juandav65/Control_Levitador_Neumatico/piston (1).pdf

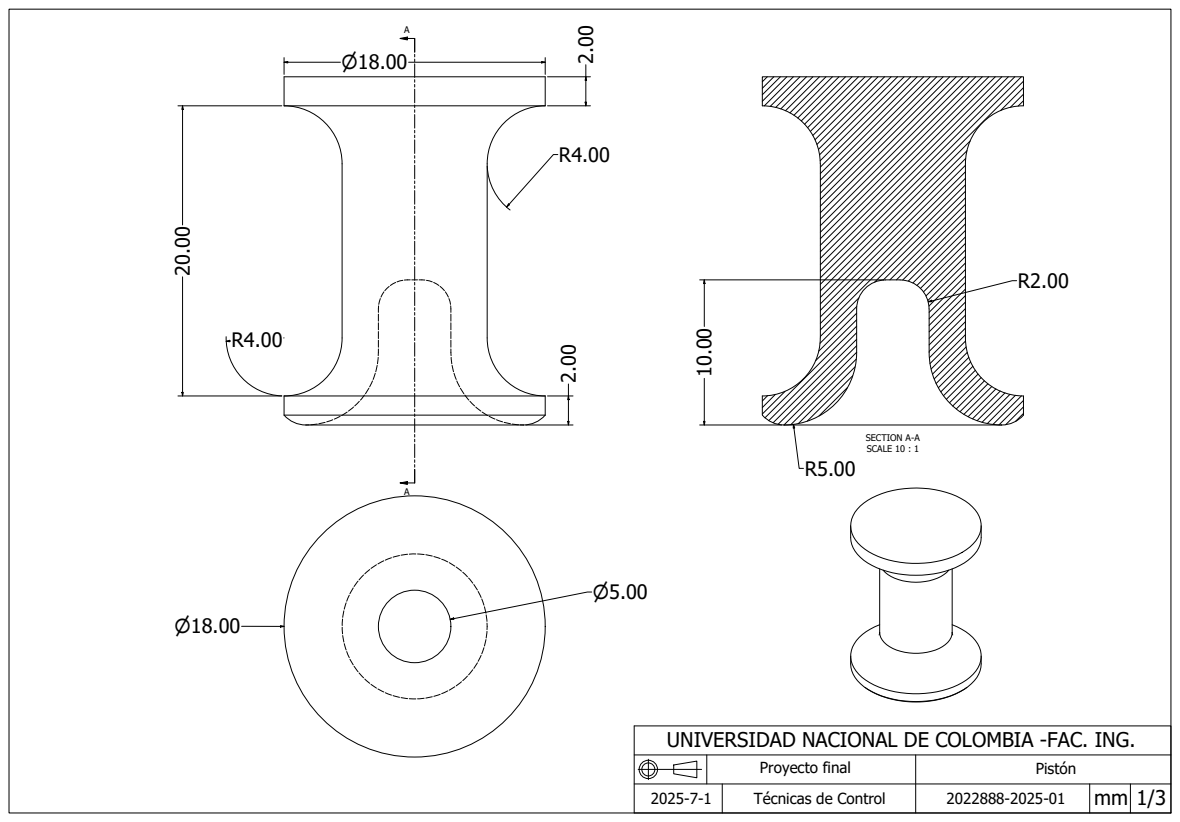
[picture p1: page 1]
SECTION A-A SCALE 10 : 1

UNIVERSIDAD NACIONAL DE COLOMBIA -FAC. ING.

Proyecto final | Pistón

2025-7-1 | Técnicas de Control | 2022888-2025-01 | mm | 1/3
