juandav65/Control_Levitador_Neumatico/BaseProyectoLevitador.pdf

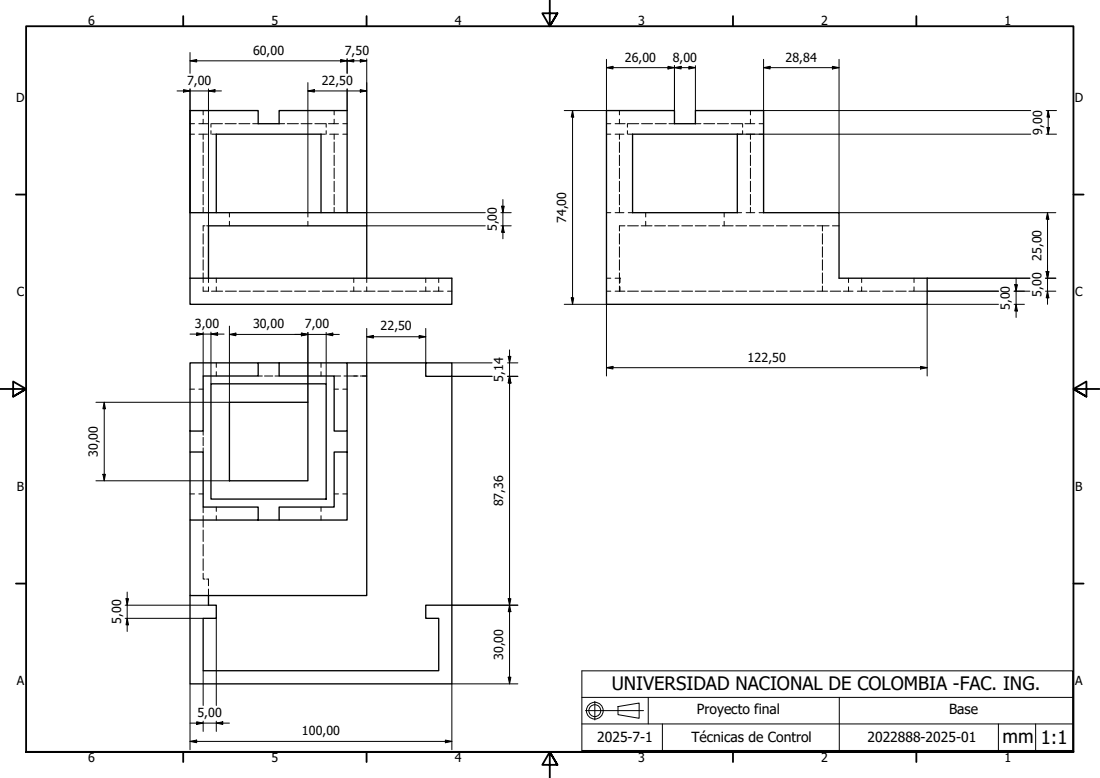
[picture p2: page 1]

UNIVERSIDAD NACIONAL DE COLOMBIA -FAC. ING.

Proyecto final | Base

2025-7-1 | Técnicas de Control | 2022888-2025-01 | mm | 1:1
