juandav65/Control_Levitador_Neumatico/Tapa.pdf

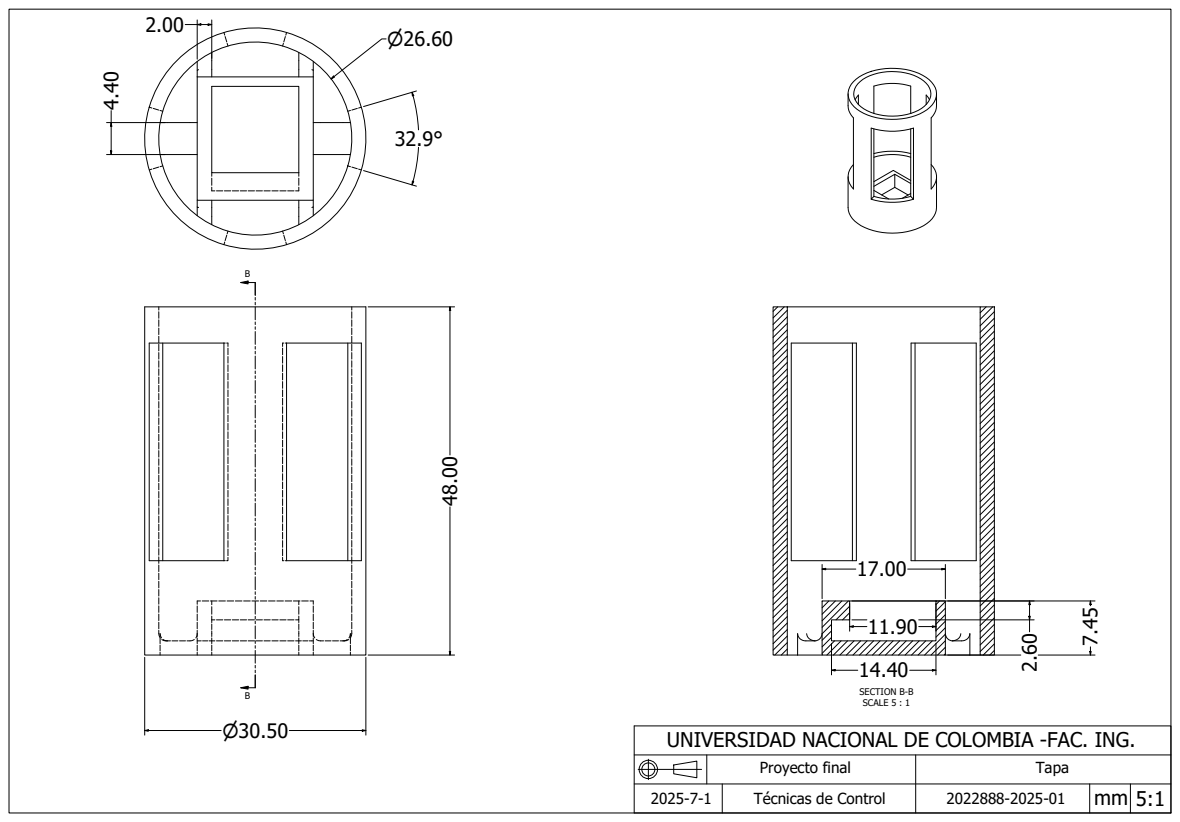
[picture p3: page 1]
SECTION B-B SCALE 5 : 1

UNIVERSIDAD NACIONAL DE COLOMBIA -FAC. ING.

Proyecto final | Tapa

2025-7-1 | Técnicas de Control | 2022888-2025-01 | mm | 5:1
